dawkoz/wirelessSeederController/(commit log)

2025-02-22 working system without WOM sensor on the seeder module
2026-09-18 settings for different metering unit gear ratios
2026-09-19 calibration data exporting, displaying upgraded
2026-09-21 wiring schematics added, reverse polarity diode removed
2026-09-25 extra test added (reving the motor for 5 seconds)
2026-09-25 work screen tramline displaying fix
    [main.cpp]
2026-09-27 button fix
2026-09-27 button fix (delay was too big)
    [machine_settings.h, main.cpp]
2026-09-27 switched back to 3 magnets
2026-09-28 dispenser burst metering for the weak motor
    The fitted motor cannot turn the loaded auger at a low duty, so each wheel
    pulse is now dosed as one burst: BURST_PWM_FRACTION of full PWM (default
    1.0) until the encoder has counted that pulse's share of the ground, stopped
    on the exact count between control steps. The calibration run turns at the
    same PWM. A shaft that nearly stalls mid-burst gets full PWM until it turns;
    only one that full PWM cannot move is a clog. ZA SZYBKO when the motor falls
    more than a pulse behind twice in a row.
    DISPENSER_BURST_MODE = false restores the continuous metering unchanged.
    Dispenser only, no protocol change: only the dispenser needs reflashing, and
    it must be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
    [dispenser_io.cpp, dispenser_io.h, dispenser_logic.h, machine_settings.h, main.cpp, tests_burst.h, tests_burst_motor.h, tests_logic.h]
2026-09-28 new screens and calibration logic
2026-09-30 relay and brust logic changed
